OhYou-0/thinkpad/x301/FHDmod/photos/001.jpg

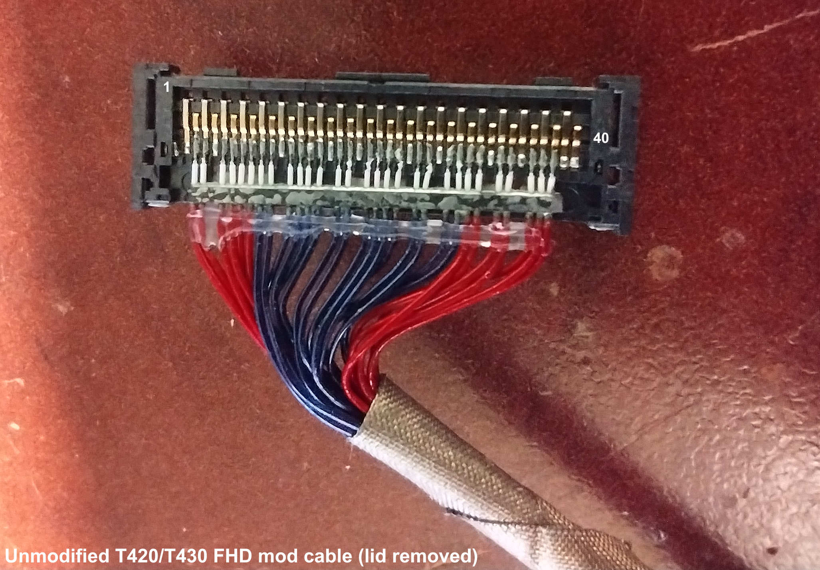
x301/FHDmod/photos/001.jpg
