OhYou-0/thinkpad/x301/FHDmod/photos/003.jpg

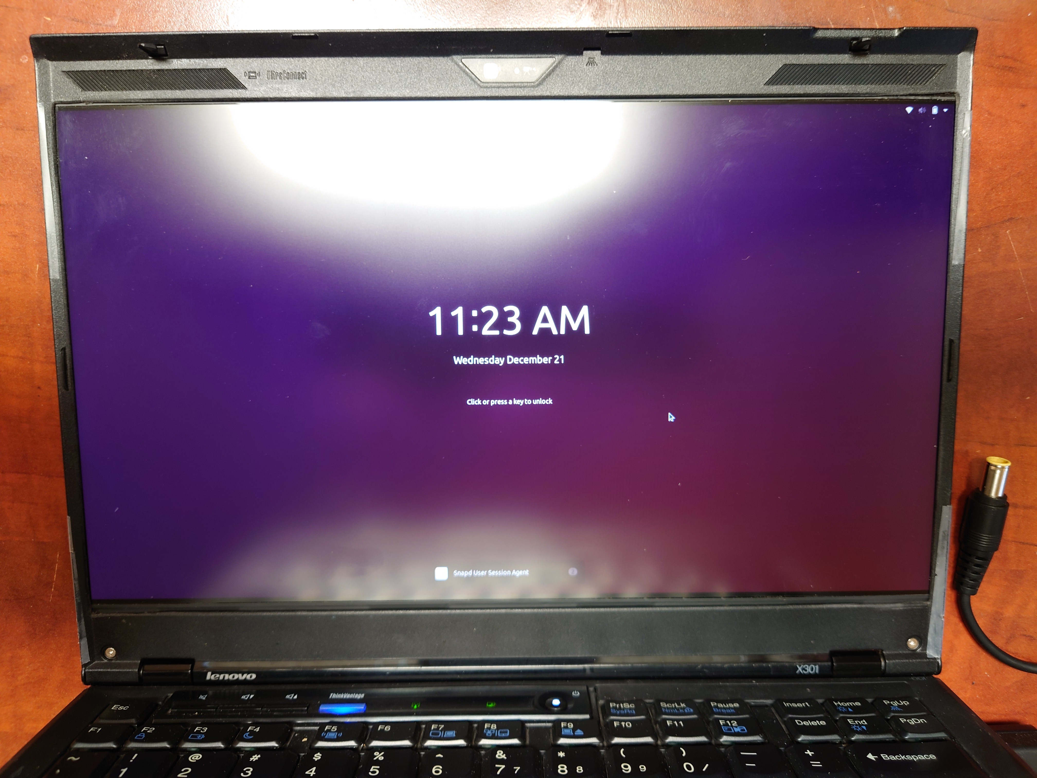
x301/FHDmod/photos/003.jpg
