OhYou-0/thinkpad/x301/Libreboot/README.md

ver: 20211122
flashing: rpi zero (spi)
power: rpi power source, board unpowered, battery out
method: jumpers soldered to wson8 pads
display: works fine with FHD mod
notes: laptop does not recover from suspend, instead reboots. possibly OS or kernel related
	tp_smapi kernel module will not load, does not find hardware. thinkpad_ec also showing errors in boot log.
