OhYou-0/thinkpad/x301/FHDmod/photos/README.md

001: unmodified plug for T420/T430 thinkpad FHD mod
002: location suitable for bridge pcb (requires wlan relocation)(oncompatible with SD/USB3 mod)
003: cut bezel to fit 14in LCD panel
