OhYou-0/thinkpad/x301/FHDmod/photos/002.jpg

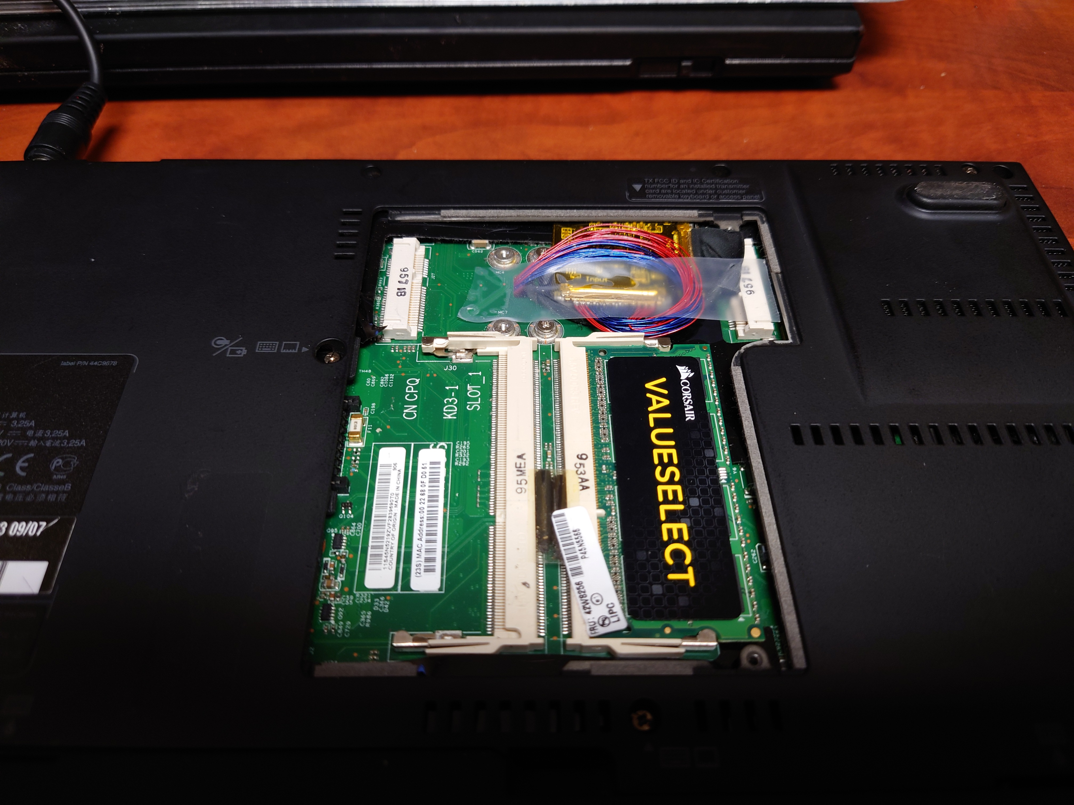
x301/FHDmod/photos/002.jpg
