OhYou-0/thinkpad/x301/FHDmod/schematics/unmodified_FHD_cable.png

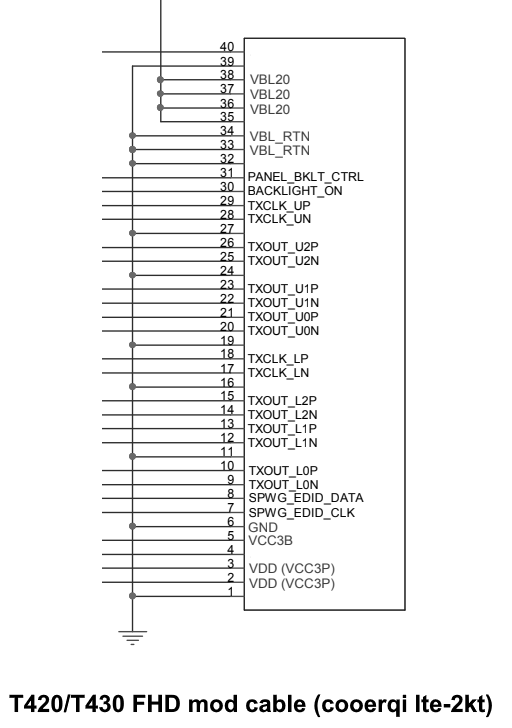
x301/FHDmod/schematics/unmodified_FHD_cable.png
