OhYou-0/thinkpad/x301/FHDmod/schematics/x301_port.png

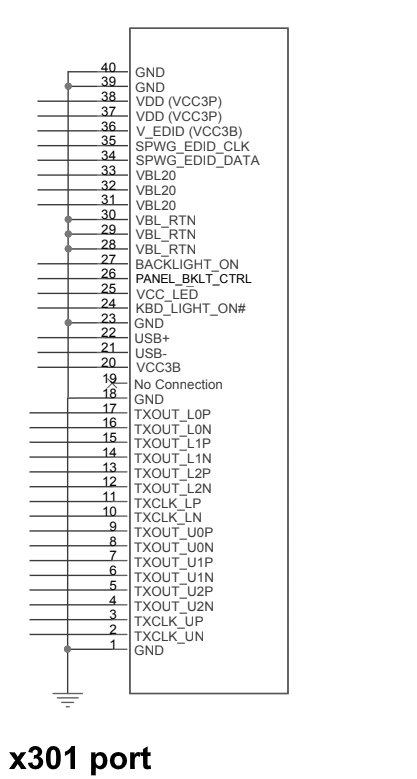
x301/FHDmod/schematics/x301_port.png
